ayuusweetfish/Petit-Soleil-Lenormand/cards/card_illustrations/01_outline.png

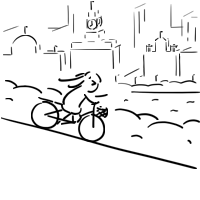
cards/card_illustrations/01_outline.png
