ayuusweetfish/Petit-Soleil-Lenormand/cards/card_illustrations/01_shadow.png

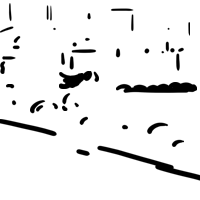
cards/card_illustrations/01_shadow.png
