ayuusweetfish/Petit-Soleil-Lenormand/cards/card_illustrations/08_outline.png

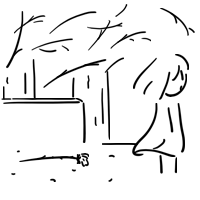
cards/card_illustrations/08_outline.png
