ayuusweetfish/Petit-Soleil-Lenormand/cards/card_illustrations/08_shadow.png

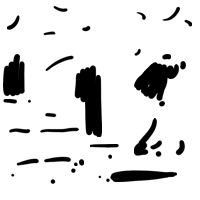
cards/card_illustrations/08_shadow.png
