ayuusweetfish/Petit-Soleil-Lenormand/cards/card_illustrations/09_outline.png

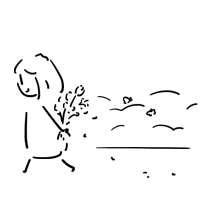
cards/card_illustrations/09_outline.png
