ayuusweetfish/Petit-Soleil-Lenormand/cards/card_illustrations/09_shadow.png

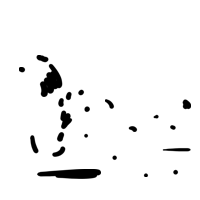
cards/card_illustrations/09_shadow.png
