ayuusweetfish/Petit-Soleil-Lenormand/cards/card_illustrations/31_outline.png

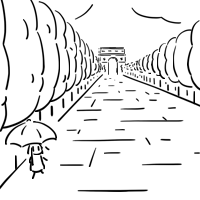
cards/card_illustrations/31_outline.png
