ayuusweetfish/Petit-Soleil-Lenormand/cards/card_illustrations/31_shadow.png

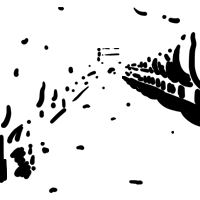
cards/card_illustrations/31_shadow.png
