ayuusweetfish/Petit-Soleil-Lenormand/cards/card_illustrations/32_outline.png

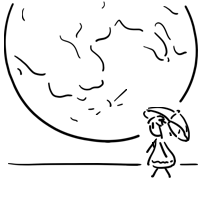
cards/card_illustrations/32_outline.png
