ayuusweetfish/Petit-Soleil-Lenormand/cards/card_illustrations/32_shadow.png

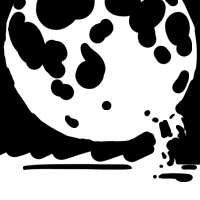
cards/card_illustrations/32_shadow.png
