ayuusweetfish/Petit-Soleil-Lenormand/cards/card_illustrations/34_outline.png

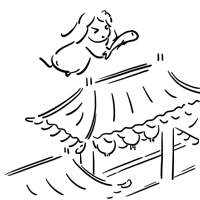
cards/card_illustrations/34_outline.png
