ayuusweetfish/Petit-Soleil-Lenormand/cards/card_illustrations/34_shadow.png

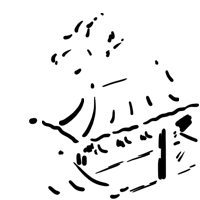
cards/card_illustrations/34_shadow.png
