ayuusweetfish/Petit-Soleil-Lenormand/hw/XS3A1T3157GMX.stp

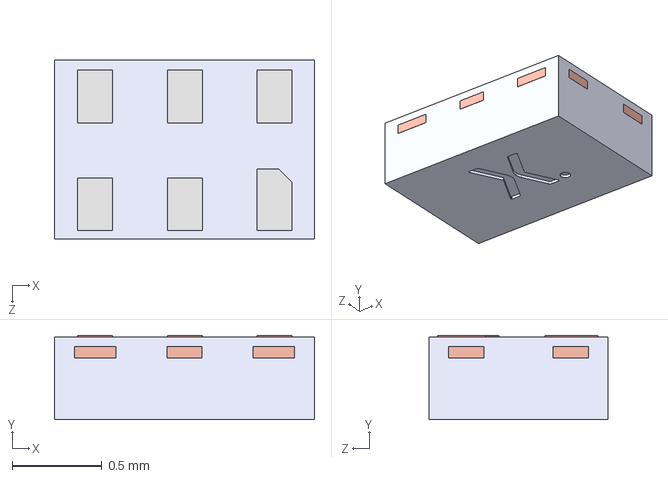
[picture p13: CAD file, 2024-03-11]
hw/XS3A1T3157GMX.stp
1.45 x 0.47 x 1.00 mm
SOT886 LF
SOT886 Mold Body
