ayuusweetfish/Petit-Soleil-Lenormand/hw/W25Q16JVUXIQ.stp

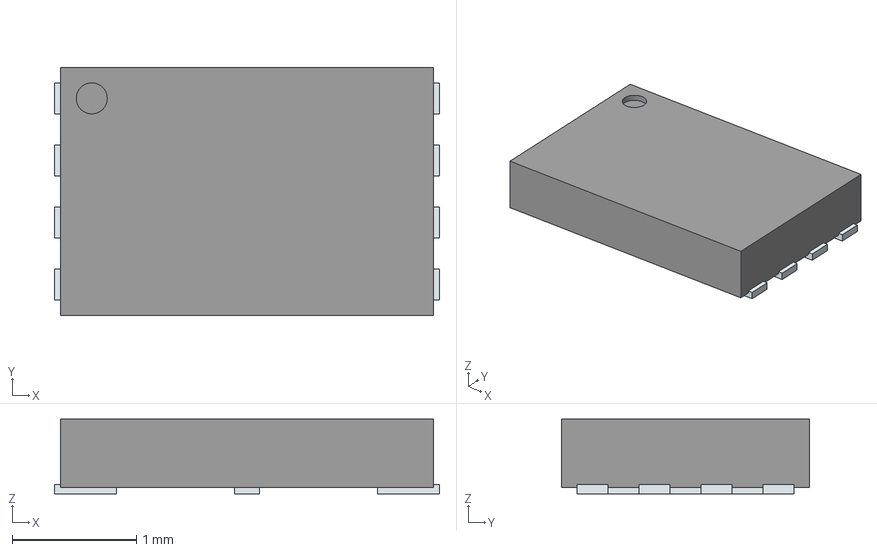
[picture p14: CAD file, 2024-03-11]
hw/W25Q16JVUXIQ.stp
3.10 x 2.00 x 0.6 mm
ThermalPin
PinsArrayLR
