ayuusweetfish/Petit-Soleil-Lenormand/hw/EPD-BodySketch.dxf

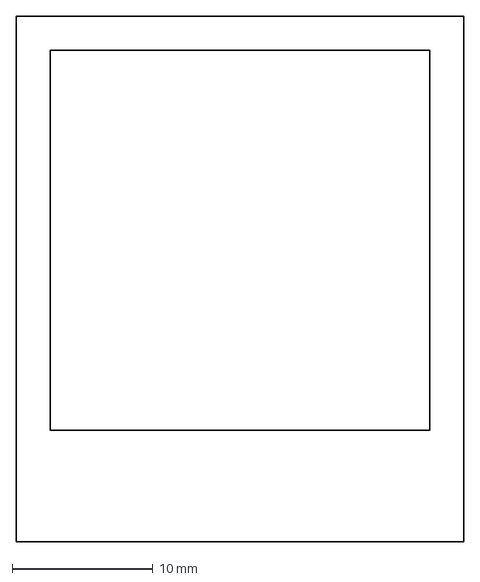
[picture p15: CAD file, 2023-12-23]
hw/EPD-BodySketch.dxf
31.8 x 37.3 mm
