ayuusweetfish/Petit-Soleil-Lenormand/hw/TPS61020DRCR.stp

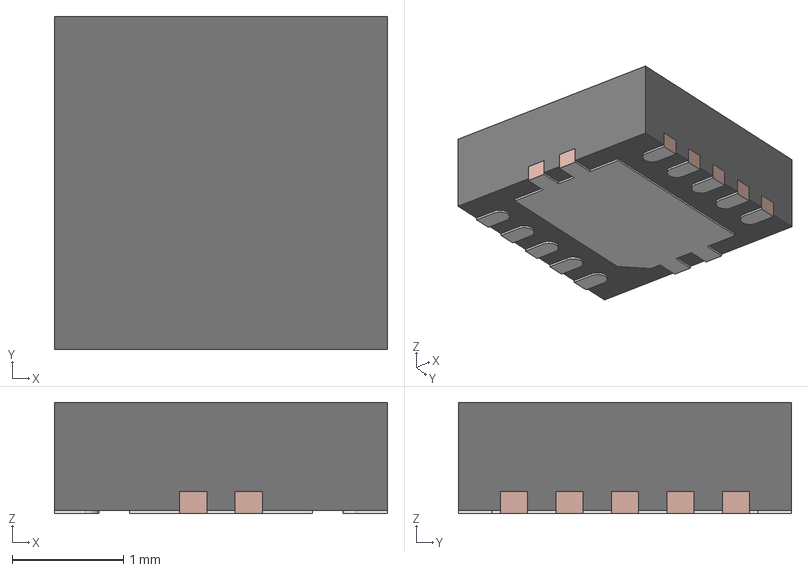
[picture p16: CAD file, 2024-07-13]
hw/TPS61020DRCR.stp
3.00 x 3.00 x 1.00 mm
BODY-SON
FRAME-DRC0010J
