ayuusweetfish/Petit-Soleil-Lenormand/(list of files, cad)

Other CAD files:
hw/EPD.FCStd
