ayuusweetfish/Petit-Soleil-Lenormand/beacon/page/verify.html

{{@zh}} {{@en}} Home

{{@zh}}

## 验证

{{@en}}

## Verification

1. Download the images involved.

curl{{~a' details \
'{{ url }}' -o {{ index }}.{{ extension }} a'~}}

2. Check the file signatures.

openssl dgst -sha3-224{{~b1' details {{ index }}.{{ extension }} b1'~}}
{{~b2' details SHA3-224({{ index }}.{{ extension }})= {{ digest }}
b2'~}} curl https://abrc.ayu.land/{{ latestTimestamp }} | perl -nle 'print join "\n", m/"digest":"([0-9a-f]+)"/g'
{{~b3' details {{ digest }}
b3'~}}

3. Retrieve and verify local randomness.

VRF_PK={{ vrfPk }}
VRF_PROOF={{ vrfProof }}
LOCAL=$(./vrf-verify $VRF_PK {{ latestTimestamp }} $VRF_PROOF)
echo ${LOCAL::16}...${LOCAL:(-16)}
{{ vrfOutputPrefixSuffix }}

4. Calculate combined hash from local randomness and all files.

HASH=$(i=0; while [ $i -lt 64 ]; do echo $LOCAL | LC_ALL=C awk '{ for (i = 0; i < 256; i++) { hex[sprintf("%02x", i)] = i; } for (i = 1; i <= length($0); i += 2) { printf("%c", (hex[substr($0, i, 2)] + (i == 1 ? '"$i"' : 0)) % 256) } }' | cat -{{~c' details {{ index }}.{{ extension }} c'~}} | openssl dgst -sha3-512 | awk '{ printf "%s", $2 }'; i=$((i + 1)); done)
echo ${HASH::16}...${HASH:(-16)}
{{ currentCombinedPrefixSuffix }}

5. Retrieve the previous pulse’s output ({{ previousTimestampISO }}).

PREV=$(curl https://abrc.ayu.land/{{ previousTimestamp }} | perl -ne 'm/"output":"([0-9a-f]+)"/; print "$1"'); echo ${PREV:0:16}...${PREV:(-16)}
{{ previousOutputPrefixSuffix }}

6. Calculate the bitwise exclusive-or of the combined hash (step 4) and the previous pulse’s output (step 5).

python3 -c "print('%08192x' % (0x$HASH ^ 0x$PREV))"
{{ latestOutputPrefixSuffix }}
perl -Mbigint -le "printf \"%08192s\n\", (0x$HASH ^ 0x$PREV)->copy()->to_hex()"
{{ latestOutputPrefixSuffix }}
echo $HASH $PREV | gawk '{ for (i=1; i<=8192; i++) printf("%x", xor(strtonum("0x" substr($1,i,1)), strtonum("0x" substr($2,i,1)))) }'
{{ latestOutputPrefixSuffix }}

This is the output of the latest pulse ({{ latestTimestampISO }}).

PREV=$(curl https://abrc.ayu.land/{{ latestTimestamp }} | perl -ne 'm/"output":"([0-9a-f]+)"/; print "$1"'); echo ${PREV:0:16}...${PREV:(-16)}
{{ latestOutputPrefixSuffix }}

Nuvens… São como eu, uma passagem desfeita entre o céu e a terra, ao sabor de um impulso invisível, trovejando ou não trovejando, alegrando brancas ou escurecendo negras, ficções do intervalo e do descaminho, longe do ruído da terra e sem ter o silêncio do céu.

{{@zh}}

「云……它们就像我，是天地之间残败的通道，在某种无形冲动的摆布之下，时有时无地发出雷鸣，时而欢快雪白、时而阴郁漆黑；它们是断裂与游离的假象，远离地上的喧嚣，亦没有天空的宁静。」

{{@en}}

“Clouds… They’re like me, a ravaged passage between the sky and the land, at the mercy of an invisible impulse, thundering or not thundering, cheerfully white or gloomily black, fictions of break and detour, distant from the noises of the land and without the silence of the sky.”

{{@zh}}

《不安之书》（Livro do Desassossego）
费尔南多·佩索阿（Fernando Pessoa）

{{@en}}

The Book of Disquiet (Livro do Desassossego)
Fernando Pessoa
