ayuusweetfish/Petit-Soleil-Lenormand/hw/Soleil.kicad_pcb

## KiCad design hw/Soleil.kicad_pcb (2024-07-19)

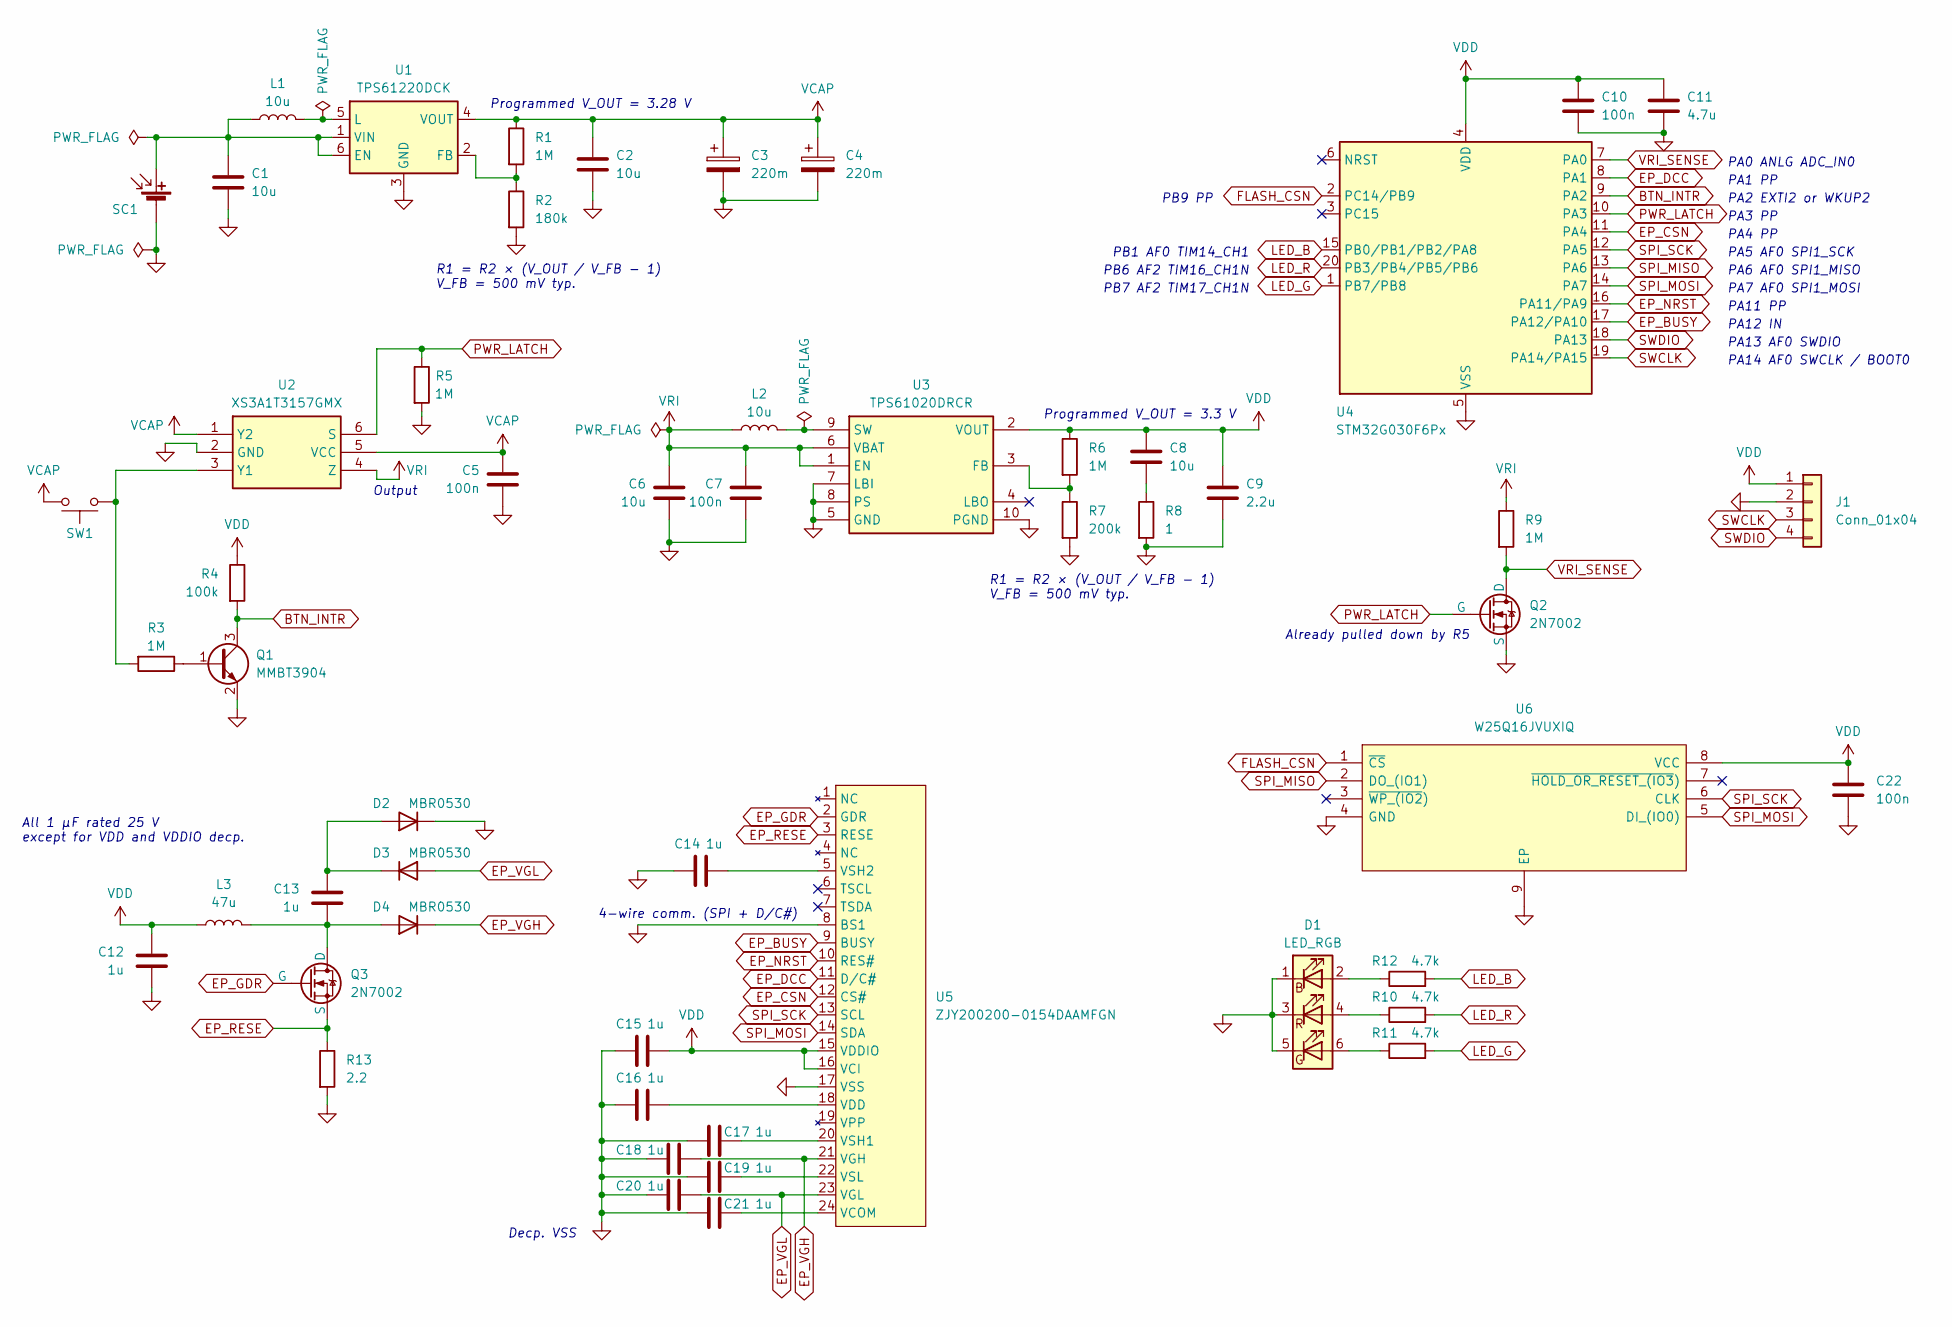
[picture p17: schematic Soleil.kicad_sch]

Parts:
C1, C2, C6, C8: 10u; C_0402_1005Metric
C3, C4: 220m; DMS3R3
C5, C7, C10, C22: 100n; C_0402_1005Metric
C9: 2.2u; C_0402_1005Metric
C11: 4.7u; C_0402_1005Metric
C12, C13, C14, C15, C16, C17, C18, C19, C20, C21: 1u; C_0402_1005Metric
D1: LED_RGB; LED_BRG_KA_5050-6
D2, D3, D4: MBR0530; D_SOD-123
J1: Conn_01x04; TestPoints_1x04_P2.0
L1, L2: 10u; L_Sunlord_SWPA252012S
L3: 47u; L_Sunlord_SWPA4020S
Q1: MMBT3904; SOT-23
Q2, Q3: 2N7002; SOT-23
R1, R3, R5, R6, R9: 1M; R_0402_1005Metric
R2: 180k; R_0402_1005Metric
R4: 100k; R_0402_1005Metric
R7: 200k; R_0402_1005Metric
R8: 1; R_0402_1005Metric
R10, R11, R12: 4.7k; R_0402_1005Metric
R13: 2.2; R_0402_1005Metric
SC1: Solar_Cell; SolarPanel_3025
SW1: SW_Push; SW_SPST_TL3342
U1: TPS61220DCK; Texas_R-PDSO-G6
U2: XS3A1T3157GMX; Manufacturer_Part_Number XS3A1T3157GMX; Mouser Part Number 771-XS3A1T3157GMX
U3: TPS61020DRCR; Manufacturer_Part_Number TPS61020DRCR; Mouser Part Number 595-TPS61020DRCR
U4: STM32G030F6Px; TSSOP-20_4.4x6.5mm_P0.65mm
U5: ZJY200200-0154DAAMFGN; FPC_1x24_P0.5
U6: W25Q16JVUXIQ; SON50P300X200X60-9N; Manufacturer_Part_Number W25Q16JVUXIQ

Connections:
BTN_INTR: Q1.3 (C), R4.2, U4.9 (PA2)
EP_BUSY: U4.17 (PA12/PA10), U5.9 (BUSY)
EP_CSN: U4.11 (PA4), U5.12 (CS#)
EP_DCC: U4.8 (PA1), U5.11 (D/C#)
EP_GDR: Q3.1 (G), U5.2 (GDR)
EP_NRST: U4.16 (PA11/PA9), U5.10 (RES#)
EP_RESE: Q3.2 (S), R13.1, U5.3 (RESE)
EP_VGH: C18.2, D4.1 (K), U5.21 (VGH)
EP_VGL: C20.2, D3.2 (A), U5.23 (VGL)
FLASH_CSN: U4.2 (PC14/PB9), U6.1 (~CS)
GND: C1.2, C2.2, C3.2, C4.2, C5.1, C6.2, C7.2, C9.2, C10.1, C11.1, C12.2, C14.1, C15.1, C16.1, C17.1, C18.1, C19.1, C20.1, C21.1, C22.1, D1.1 (BK), D1.3 (RK), D1.5 (GK), D2.1 (K), J1.2, Q1.2 (E), Q2.2 (S), R2.2, R5.2, R7.2, R8.2, R13.2, SC1.2 (-), U1.3 (GND), U2.2 (GND), U3.5 (GND), U3.7 (LBI), U3.8 (PS), U3.10 (PGND), U3.11 (EP/PGND_1), U3.A11 (EP/PGND_2), U3.B11 (EP/PGND_3), U3.C11 (EP/PGND_4), U3.D11 (EP/PGND_5), U4.5 (VSS), U5.8 (BS1), U5.17 (VSS), U6.4 (GND), U6.9 (EP)
LED_B: R12.2, U4.15 (PB0/PB1/PB2/PA8)
LED_G: R11.2, U4.1 (PB7/PB8)
LED_R: R10.2, U4.20 (PB3/PB4/PB5/PB6)
unnamed: C8.2, R8.1
unnamed: D1.2 (BA), R12.1
unnamed: D1.6 (GA), R11.1
unnamed: D1.4 (RA), R10.1
unnamed: C13.1, D2.2 (A), D3.1 (K)
unnamed: C13.2, D4.2 (A), L3.2, Q3.3 (D)
unnamed: Q1.1 (B), R3.1
unnamed: C1.1, L1.1, SC1.1 (+), U1.1 (VIN), U1.6 (EN)
unnamed: R1.2, R2.1, U1.2 (FB)
unnamed: L1.2, U1.5 (L)
unnamed: R3.2, SW1.2, U2.3 (Y1)
unnamed: R6.2, R7.1, U3.3 (FB)
unnamed: L2.2, U3.9 (SW)
unnamed: C21.2, U5.24 (VCOM)
unnamed: C16.2, U5.18 (VDD)
unnamed: C17.2, U5.20 (VSH1)
unnamed: C14.2, U5.5 (VSH2)
unnamed: C19.2, U5.22 (VSL)
PWR_LATCH: Q2.1 (G), R5.1, U2.6 (S), U4.10 (PA3)
SPI_MISO: U4.13 (PA6), U6.2 (DO_(IO1))
SPI_MOSI: U4.14 (PA7), U5.14 (SDA), U6.5 (DI_(IO0))
SPI_SCK: U4.12 (PA5), U5.13 (SCL), U6.6 (CLK)
SWCLK: J1.3, U4.19 (PA14/PA15)
SWDIO: J1.4, U4.18 (PA13)
VCAP: C2.1, C3.1, C4.1, C5.2, R1.1, SW1.1, U1.4 (VOUT), U2.1 (Y2), U2.5 (VCC)
VDD: C8.1, C9.1, C10.2, C11.2, C12.1, C15.2, C22.2, J1.1, L3.1, R4.1, R6.1, U3.2 (VOUT), U4.4 (VDD), U5.15 (VDDIO), U5.16 (VCI), U6.8 (VCC)
VRI: C6.1, C7.1, L2.1, R9.1, U2.4 (Z), U3.1 (EN), U3.6 (VBAT)
VRI_SENSE: Q2.3 (D), R9.2, U4.7 (PA0)

Notes on the sheet:
PA12 IN
Programmed V_OUT = 3.3 V
PB7 AF2 TIM17_CH1N
PA11 PP
PA3 PP
PA7 AF0 SPI1_MOSI
4-wire comm. (SPI + D/C#)
PB6 AF2 TIM16_CH1N
PB1 AF0 TIM14_CH1
PB9 PP
R1 = R2 × (V_OUT / V_FB - 1) V_FB = 500 mV typ.
Decp. VSS
All 1 µF rated 25 V except for VDD and VDDIO decp.
PA1 PP
PA0 ANLG ADC_IN0
PA4 PP
PA5 AF0 SPI1_SCK
Already pulled down by R5
Output
PA14 AF0 SWCLK / BOOT0
PA6 AF0 SPI1_MISO
Programmed V_OUT = 3.28 V
PA2 EXTI2 or WKUP2
PA13 AF0 SWDIO

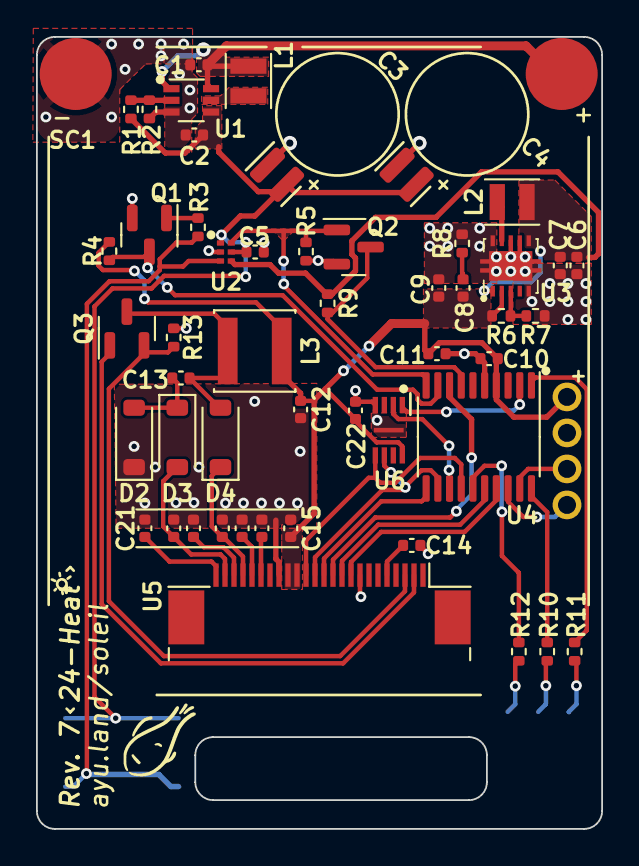
[picture p18: board hw/Soleil.kicad_pcb from above]

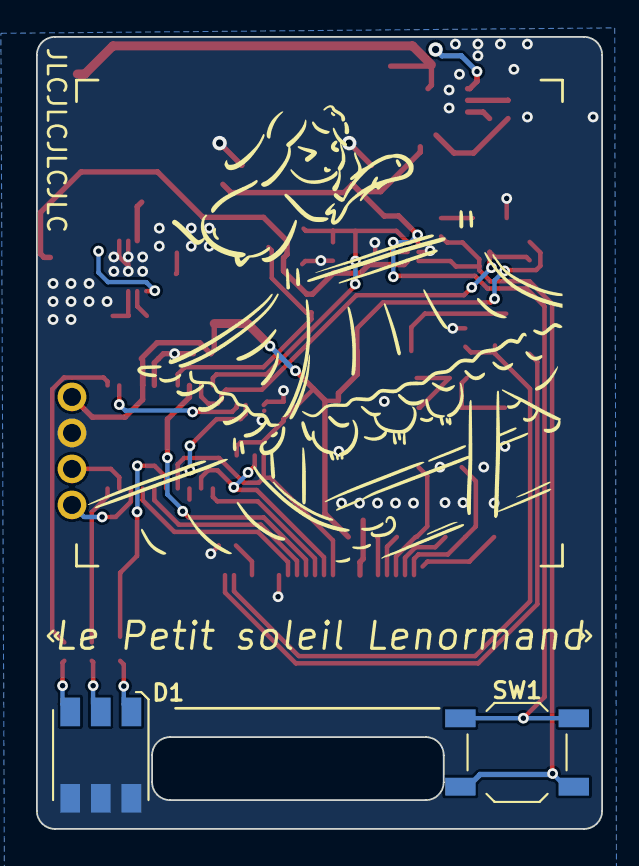
[picture p19: board hw/Soleil.kicad_pcb from below]

Board: 2 copper layers, 31.4 x 44.0 mm, 54 parts (2 on the bottom side), 42 nets.
