ayuusweetfish/Petit-Soleil-Lenormand/misc/supply_test_2/Soleil.kicad_pcb

## KiCad design misc/supply_test_2/Soleil.kicad_pcb (2024-07-13)

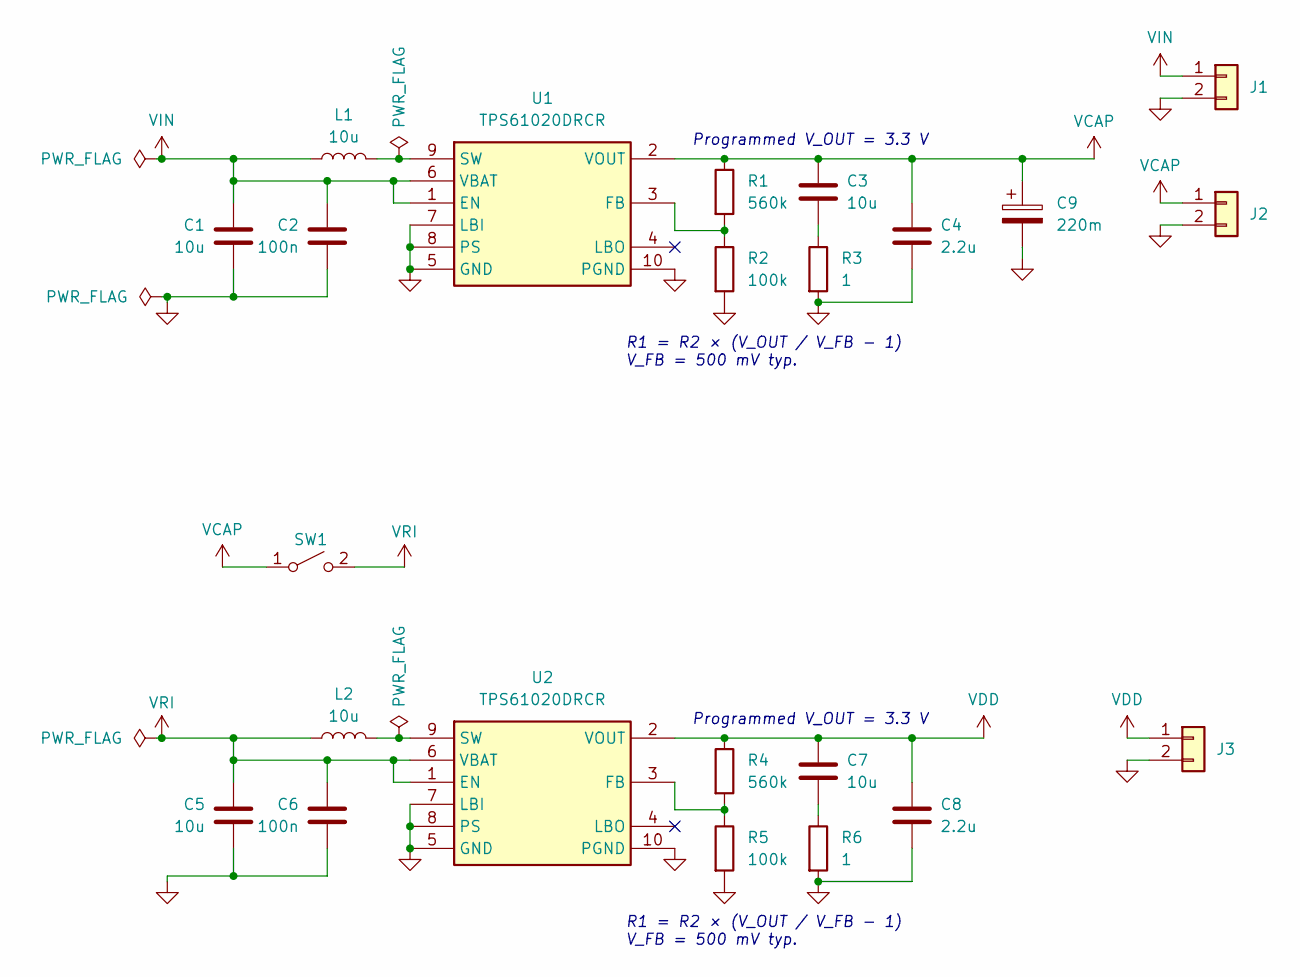
[picture p20: schematic Soleil.kicad_sch]

Parts:
C1, C3, C5, C7: 10u; C_0603_1608Metric
C2, C6: 100n; C_0603_1608Metric
C4, C8: 2.2u; C_0603_1608Metric
C9: 220m; DMS3R3
J1, J2, J3: Conn_01x02; PinHeader_1x02_P2.54mm_Vertical
L1, L2: 10u; L_Sunlord_SWPA252012S
R1, R4: 560k; R_0402_1005Metric
R2, R5: 100k; R_0402_1005Metric
R3, R6: 1; R_0402_1005Metric
SW1: SW_SPST; SPST_1x01_P2.54
U1, U2: TPS61020DRCR; Manufacturer_Part_Number TPS61020DRCR; Mouser Part Number 595-TPS61020DRCR

Connections:
GND: C1.2, C2.2, C4.2, C5.2, C6.2, C8.2, C9.2, J1.2, J2.2, J3.2, R2.2, R3.2, R5.2, R6.2, U1.5 (GND), U1.7 (LBI), U1.8 (PS), U1.10 (PGND), U1.11 (EP/PGND_1), U1.A11 (EP/PGND_2), U1.B11 (EP/PGND_3), U1.C11 (EP/PGND_4), U1.D11 (EP/PGND_5), U2.5 (GND), U2.7 (LBI), U2.8 (PS), U2.10 (PGND), U2.11 (EP/PGND_1), U2.A11 (EP/PGND_2), U2.B11 (EP/PGND_3), U2.C11 (EP/PGND_4), U2.D11 (EP/PGND_5)
unnamed: C3.2, R3.1
unnamed: C7.2, R6.1
unnamed: R1.2, R2.1, U1.3 (FB)
unnamed: L1.2, U1.9 (SW)
unnamed: R4.2, R5.1, U2.3 (FB)
unnamed: L2.2, U2.9 (SW)
VCAP: C3.1, C4.1, C9.1, J2.1, R1.1, SW1.1 (A), U1.2 (VOUT)
VDD: C7.1, C8.1, J3.1, R4.1, U2.2 (VOUT)
VIN: C1.1, C2.1, J1.1, L1.1, U1.1 (EN), U1.6 (VBAT)
VRI: C5.1, C6.1, L2.1, SW1.2 (B), U2.1 (EN), U2.6 (VBAT)

Notes on the sheet:
Programmed V_OUT = 3.3 V
R1 = R2 × (V_OUT / V_FB - 1) V_FB = 500 mV typ.

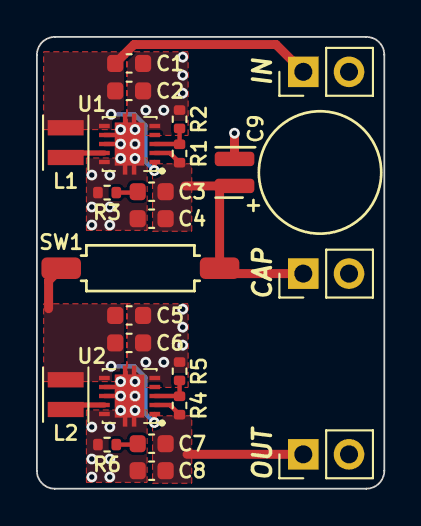
[picture p21: board misc/supply_test_2/Soleil.kicad_pcb from above]

Board: 2 copper layers, 19.3 x 25.1 mm, 23 parts (0 on the bottom side), 11 nets.
