ayuusweetfish/Petit-Soleil-Lenormand/misc/supply_test/Soleil.kicad_pcb

## KiCad design misc/supply_test/Soleil.kicad_pcb (2024-05-31, an earlier design)

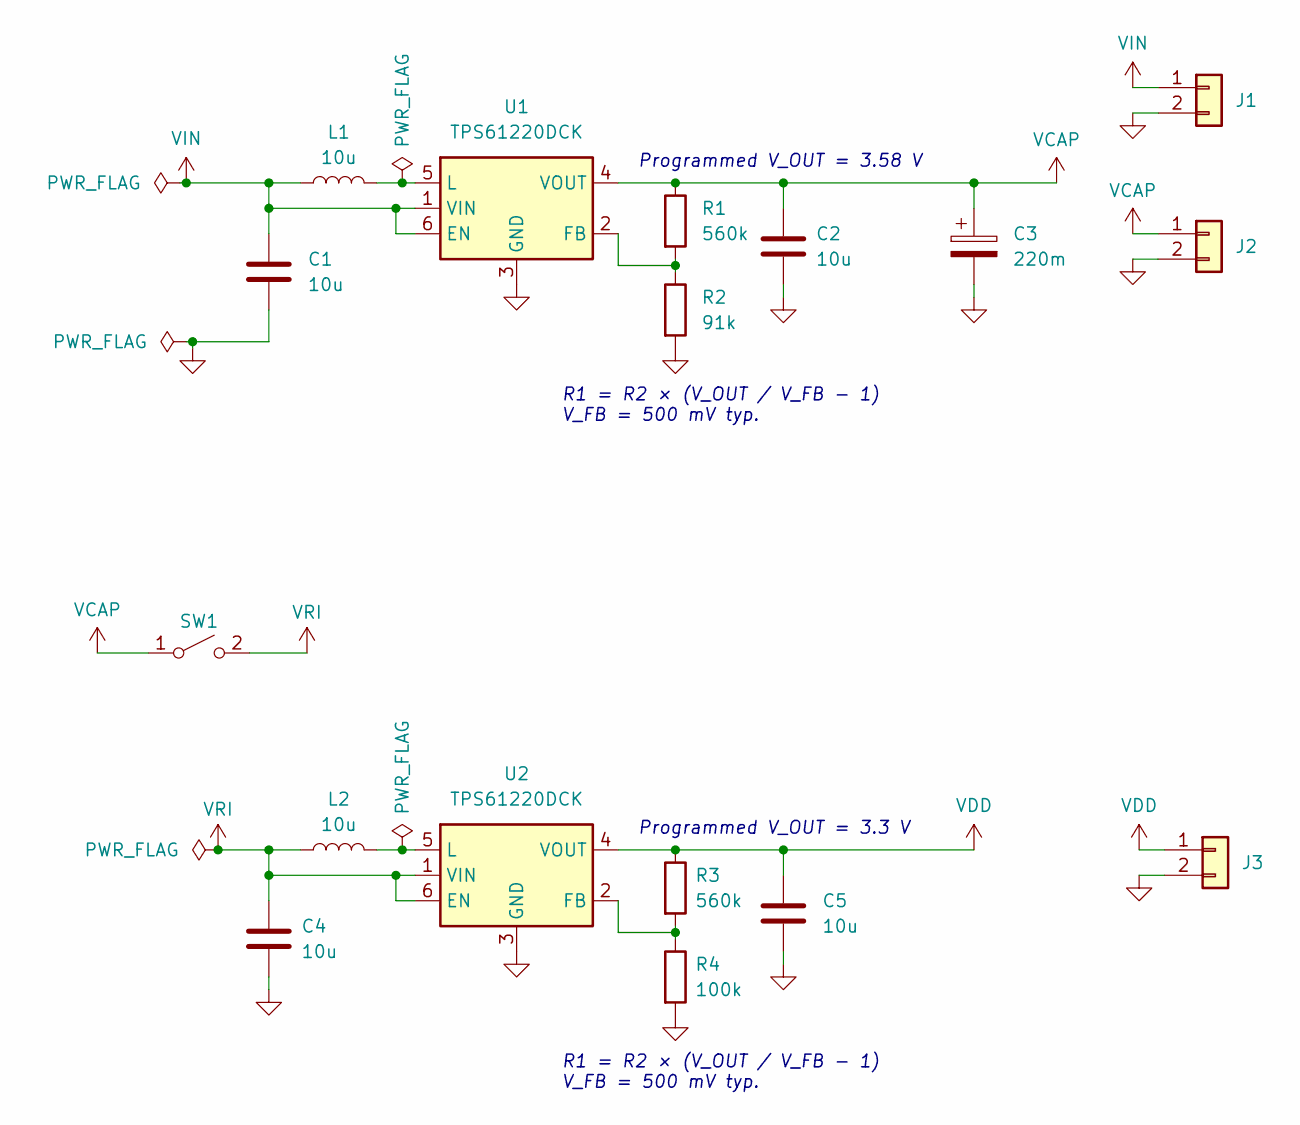
[picture p22: schematic Soleil.kicad_sch]

Parts:
C1, C2, C4, C5: 10u; C_0603_1608Metric
C3: 220m; DMS3R3
J1, J2, J3: Conn_01x02; PinHeader_1x02_P2.54mm_Vertical
L1, L2: 10u; L_Sunlord_SWPA252012S
R1, R3: 560k; R_0603_1608Metric
R2: 91k; R_0603_1608Metric
R4: 100k; R_0603_1608Metric
SW1: SW_SPST; SPST_1x01_P2.54
U1, U2: TPS61220DCK; Texas_R-PDSO-G6

Connections:
GND: C1.2, C2.2, C3.2, C4.2, C5.2, J1.2, J2.2, J3.2, R2.2, R4.2, U1.3 (GND), U2.3 (GND)
unnamed: R1.2, R2.1, U1.2 (FB)
unnamed: L1.2, U1.5 (L)
unnamed: R3.2, R4.1, U2.2 (FB)
unnamed: L2.2, U2.5 (L)
VCAP: C2.1, C3.1, J2.1, R1.1, SW1.1 (A), U1.4 (VOUT)
VDD: C5.1, J3.1, R3.1, U2.4 (VOUT)
VIN: C1.1, J1.1, L1.1, U1.1 (VIN), U1.6 (EN)
VRI: C4.1, L2.1, SW1.2 (B), U2.1 (VIN), U2.6 (EN)

Notes on the sheet:
Programmed V_OUT = 3.58 V
R1 = R2 × (V_OUT / V_FB - 1) V_FB = 500 mV typ.
Programmed V_OUT = 3.3 V

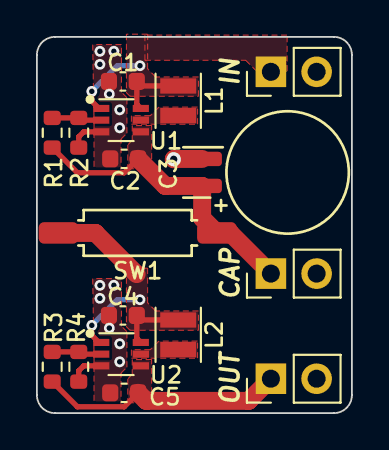
[picture p23: board misc/supply_test/Soleil.kicad_pcb from above]

Board: 2 copper layers, 17.5 x 20.9 mm, 17 parts (0 on the bottom side), 9 nets.
