ayuusweetfish/Petit-Soleil-Lenormand/(commit log)

2023-11-28 🎉 Blink
2023-11-28 Read ADC
2023-11-28 Release power latch after 10 blinks
2023-11-28 Write display and power off
2023-12-23 Sort-out; add hardware design
    [Soleil.kicad_pcb, Soleil.kicad_sch]
2023-12-23 (WIP) Update PCB layout, routing to-do
    [Soleil.kicad_pcb, Soleil.kicad_sch]
2023-12-23 Finish routing for the updated board
    [Soleil.kicad_pcb]
2023-12-23 Add capacitor voltage sensing
    [Soleil.kicad_pcb, Soleil.kicad_sch]
2023-12-23 Change LED to SMD RGB; submit for fabrication
    [Soleil.kicad_pcb, Soleil.kicad_sch]
2023-12-23 Add CAD files for EPD dimensions
    [EPD-BodySketch.dxf, EPD.FCStd]
2024-01-03 Test RGB LED PWM output with rotating hues
2024-02-29 Revise schematic
    [Soleil.kicad_sch]
2024-02-29 Revise circuit board design; submit for fab
    [Soleil.kicad_pcb, Soleil.kicad_sch]
2024-03-09 Read button pin
2024-03-09 Enable EXTI interrupt
2024-03-09 Enter Stop mode and wake up by button press
2024-03-09 Enter Stop 1 mode when idle and resume on button press
2024-03-11 Update schematic to include analogue switch and flash
    [Soleil.kicad_sch, W25Q16JVUXIQ.stp, XS3A1T3157GMX.stp]
2024-03-15 Revise and simplify schematic
    [Soleil.kicad_sch]
2024-03-16 Revise board design; submit for fab (Rev. 5)
    [Soleil.kicad_pcb, Soleil.kicad_sch]
2024-03-17 Read factory clock calibration as a source of device signature
2024-03-18 Switch to Brian Gladman's Twofish implementation
2024-03-21 Trace back in time for backup/debug usage
2024-03-21 (WIP) Adapt firmware pin definitions to Rev. 5 hardware
    [Soleil.kicad_sch]
2024-03-21 Report error messages on currently missing sources
2024-03-21 Keep reporting source URLs for current pulse after finalisation
2024-03-21 Fix falsely reporting null output for current pulse on distributed deploy environments
2024-03-22 🚧 Debugging hardware
2024-03-23 Revise hardware; fix phantom powering
    [Soleil.kicad_pcb, Soleil.kicad_sch]
2024-03-23 🚧 Further revise hardware
    [Soleil.kicad_pcb]
2024-03-23 Revise hardware and submit for fabrication (Rev. 6)
    [Soleil.kicad_pcb, Soleil.kicad_sch]
2024-03-27 Tweak page appearance on mobile devices
2024-04-03 Debug switch erroneously left on
2024-04-06 🚧 Update beacon web page
2024-05-31 Add power supply test (Rev. 6/T)
    [Soleil.kicad_pcb, Soleil.kicad_sch]
2024-05-31 Revise text style; submit for fab
    [Soleil.kicad_pcb]
2024-07-13 Add supply test 2 (with TPS61020)
    [Soleil.kicad_pcb, Soleil.kicad_sch]
2024-07-17 Add minimal power consumption test firmware
2024-07-18 Update layout, 🚧 routing to-do
    [Soleil.kicad_pcb, Soleil.kicad_sch]
2024-07-19 Finish board routing
    [Soleil.kicad_pcb, Soleil.kicad_sch]
2024-07-19 Finish board update; submit for fab (Rev. 7)
    [Soleil.kicad_pcb, Soleil.kicad_sch]
2024-07-23 Drive power latch high in firmware
2024-08-01 Adjust EPD voltage levels to reduce current consumption!
2024-08-01 Keep both clear and power-save modes
2024-08-03 🚧 Use default EPD refresh strength for testing
2024-08-04 Revise testing behaviour
    Wait for a button press before partial refresh
2024-08-06 Add missing run-length encoder program
    [main.c]
2024-08-06 Correctly read ADC value
    [Soleil.kicad_sch]
2024-08-06 Raise LED PWM frequency to 4 kHz again
2024-08-06 Print voltage on screen
2024-08-07 Use power-save mode with low battery
2024-08-08 Attempts at reducing current consumption
2024-08-24 🚧 Process BDF font
2024-08-25 Correctly read font data from flash IC
    [main.c]
2024-08-25 Print strings with the bitmap font
2024-08-27 🚧 Combine cards data into a binary file
2024-08-27 🎉 Reading and displaying images and overlays from flash!
2024-08-27 🔮 Randomise!
2024-08-28 Mix in TIM3 during ADC entropy accumulation
2024-08-28 🚧 How to correctly use this greyscale waveform?
    [main.c]
2024-08-28 Cannot adjust for a lighter grey; reverting
    [main.c]
2024-08-28 Revert "🚧 How to correctly use this greyscale waveform?"
    This reverts commit a8e2c3f7c570e677563b1503fb4a05057738aff8.
    [main.c]
2024-08-29 Separate outline and shadow images! 💐
2024-08-30 Poke around with timers
2024-08-30 Switch red LED to TIM3, freeing up TIM16 for LSI entropy
2024-08-31 Fix incorrect LSI counter initialisation
    [main.c]
2024-08-31 Throttling on button release detection
2024-09-01 Switch to Xoodoo for cryptographic permutation
2024-09-01 Revamp button interaction logic
2024-09-01 Take entropy from button interactions
2024-09-01 🚧 RTC??
2024-09-02 Implement 2 minutes power-off timeout by RTC
2024-09-02 Draw a new card with a long key press (revised button debouncing)
2024-09-02 Timing issues, once and for all (hopefully)
    [main.c]
2024-09-11 🚧 Try to read floating SWD pins (not employing)
2024-09-11 Reading captured timer counts through interrupts
2024-09-11 Revert previous changes; revise clock jitter entropy algorithm (sync Luminography)
    [main.c]
2024-09-11 Minor revisions (lights, sampling frequency, extra whitening by jitter entropy)
    [main.c]
2024-09-11 Fix debug statistics broken after first page cycle
    [main.c]
2024-09-12 Fix RAM entropy accumulation subroutine infinite loop
    [main.c]
2024-09-12 Refactor away division at every timer period
2024-09-12 Deep sleep during EPD busy wait? (With glitches)
    [main.c]
2024-09-12 Revert to sleep-delay for busy wait
    [main.c]
2024-09-12 Fix waiting in stop mode by debouncing the signal
    [main.c]
2024-09-13 (Untested) Add floating pin entropy source
2024-09-13 🚧 Incorporate floating pins into pool
2024-09-13 Might be partly fixing floating pin entropy (see comments)
    [main.c]
2024-09-13 🚧 Trying to reduce redundant ADC operations
2024-09-14 Finish ADC access by registers
2024-09-14 Adapt all ADC operations to the register-access subroutines
2024-09-14 Fix ADC channel > 16 incorrectly inaccessible
    Incorporating floating-pin entropy into continuous samples
    [main.c]
2024-09-14 Correct title layout for all sides
    [main.c]
2024-09-14 Calculate floating pin randomness with RCC
2024-09-14 Squeeze more entropy from the floating pin
2024-09-30 Handle prolonged key presses during sleep
    Also, overlay voltage on illustration for quicker inspection and clean up comments
2024-10-02 Testing for power consumption at idle
2024-12-04 Add stop-mode test for current consumption test
2024-12-06 Place flash in power-down in stop-mode test
2025-09-28 Switch INSAT image source to MOSDAC's INSAT-3DS archive
2025-09-28 Switch Elekto-L images to HTTPS
2025-09-28 Tighten Elektro-L lag amount
2026-01-03 fw: Trim debug print subroutines and Makefile
2026-01-03 misc: Rebuild SPI flash image?
    (Untested; offset differs from source)
2026-01-03 fw: A few switches to ease debugging
2026-01-03 misc: Add a script to dump SPI flash content
2026-01-03 fw: Newly built flash binary tested to work 🎉
2026-01-05 fw, misc: Build SPI flash image with Makefile
2026-01-07 misc: Build binary image for SPI flash content
2026-01-08 fw: Integrate PyOCD configuration into Makefile; add `print-uid` target
2026-01-08 fw: Rewrite SPI subroutines with direct register accesses
2026-01-08 fw: Fix uncleared SPI FIFO causing shifted image
    Ref: `stm32g0xx_hal_spi.c`: `SPI_EndRxTransaction()` -> `SPI_WaitFifoStateUntilTimeout()`
    [main.c]
2026-07-01 beacon: Move to 6 h offset; also report URLs in case of failure
    Both actions taken to compensate for operational delay of data sources and improve trustworthiness and verifiability
2026-07-01 beacon: Tighten up tests; disallow overwriting local entropy
2026-07-29 beacon: 🚧 Revise verification steps
2026-07-29 beacon: Xor current output with previous output; finish verify page
